turtlebot-euclid/Turtlebot_Euclid/README.md

# Turtlebot_Euclid

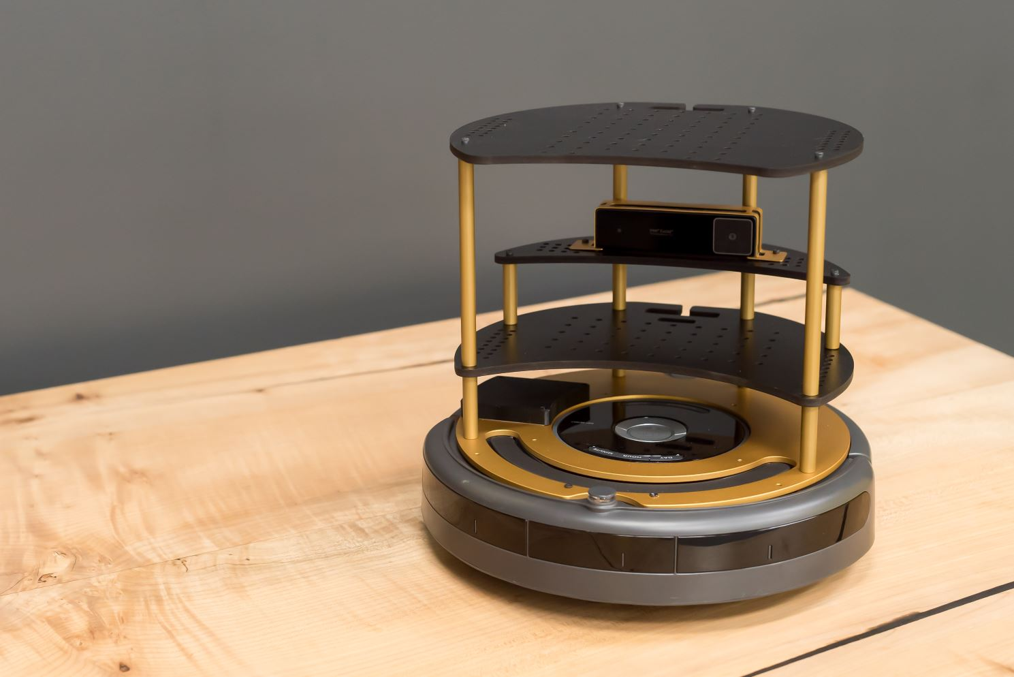
[picture p1: turtle-bot-euclid-6.jpg]
Turtlebot Euclid Promo Image


Full public repo of all design files associated with the Turtlebot Euclid
