turtlebot-euclid/Turtlebot_Euclid/Firmware/README.md

turtlebot_euclid_firmware
=========================

We use PlatformIO to program the onboard ESP8266
See tutorial here:
https://github.com/esp8266/Arduino#using-platformio
