turtlebot-euclid/Turtlebot_Euclid/Electrical/015133_C  PCB/TTBE - Main Board.step

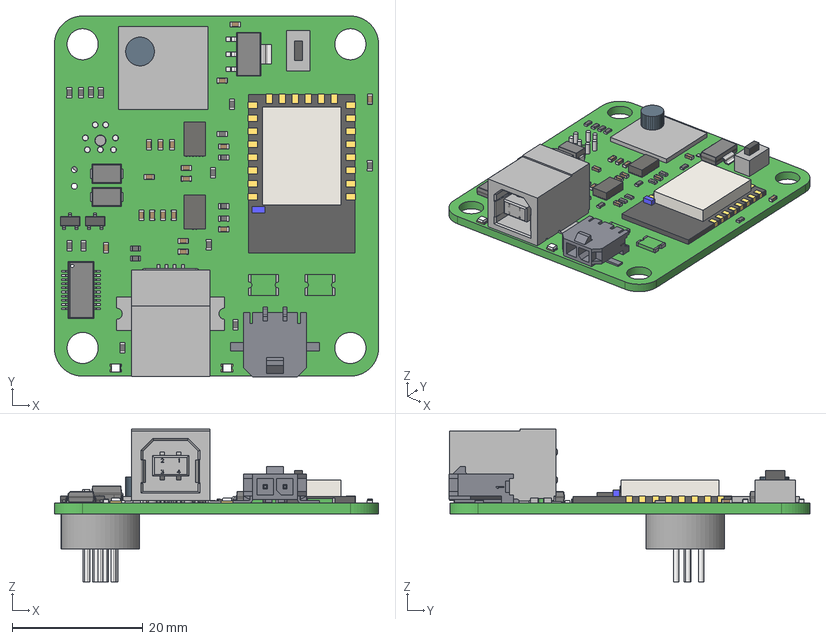
[picture p2: CAD file, 2018-04-18]
Electrical/015133_C PCB/TTBE - Main Board.step
49.6 x 55.2 x 23.4 mm
Board
User_Library-res0603-1 x 18
BL-LS0805UWC x 2
c-1734346-1-c-3d_RGB8421504
Extruded x 75
User_Library-cap_0603_lowprofile x 18
mf-msmf050_RGB32768 x 2
SW3DPS-SOT-23-DEFAULT x 2
Open_CASCADE_STEP_translator_6.8_9.1
Open_CASCADE_STEP_translator_6.8_9.2.1
Leader x 20
Open_CASCADE_STEP_translator_6.8_4.1.1
Lead x 7
Tab
Open_CASCADE_STEP_translator_6.8_7.1.1 x 2
