turtlebot-euclid/Turtlebot_Euclid/Mechanical/014845_GEO_B FOR REFRENCE ONLY.STEP

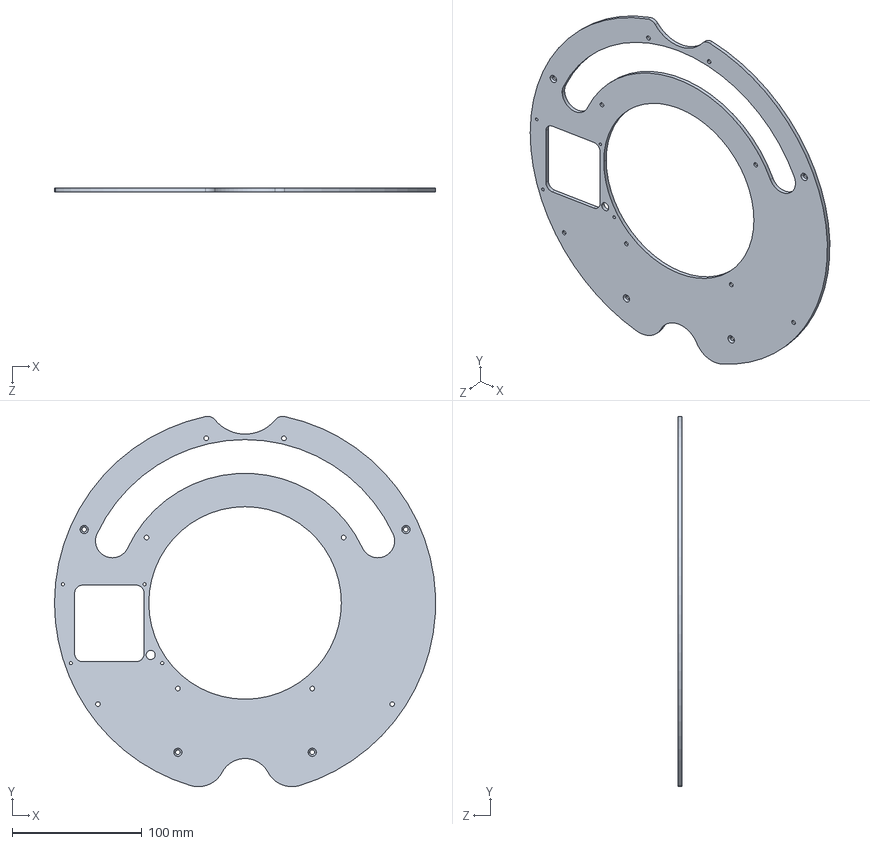
[picture p3: CAD file, 2018-04-18]
Mechanical/014845_GEO_B FOR REFRENCE ONLY.STEP
293.9 x 285.6 x 3.18 mm
