turtlebot-euclid/Turtlebot_Euclid/Mechanical/014950_GEO_B.STEP

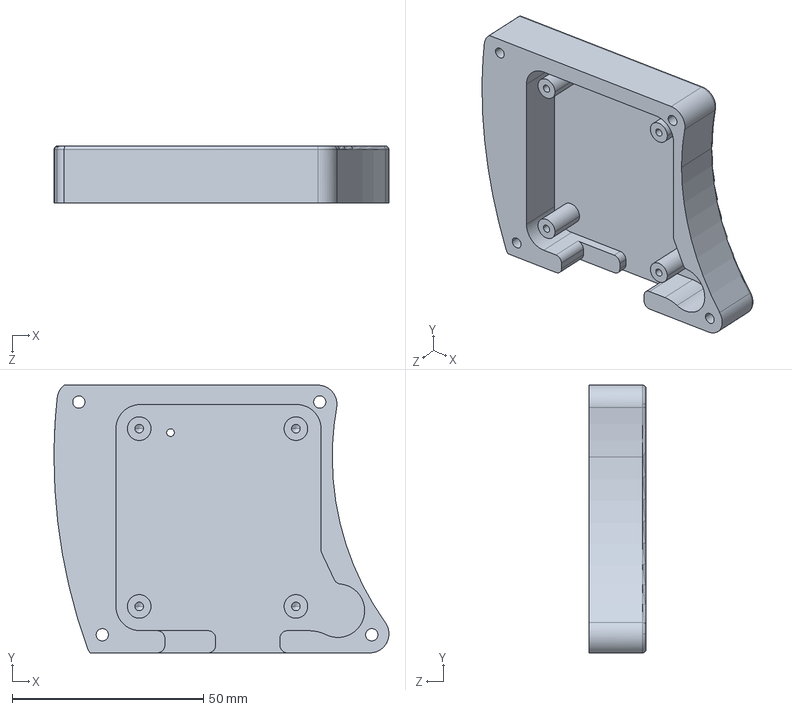
[picture p4: CAD file, 2018-04-18]
Mechanical/014950_GEO_B.STEP
87.6 x 70.0 x 15.0 mm
