turtlebot-euclid/Turtlebot_Euclid/Mechanical/014846_GEO_B FOR REFRENCE ONLY.STEP

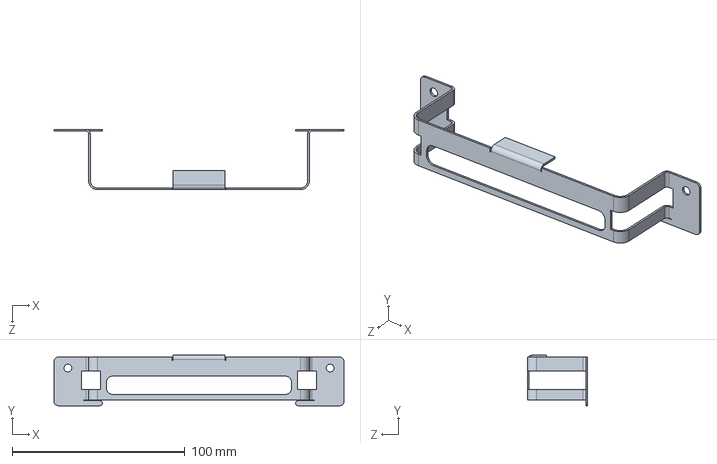
[picture p5: CAD file, 2018-04-18]
Mechanical/014846_GEO_B FOR REFRENCE ONLY.STEP
168.0 x 29.3 x 35.0 mm
