turtlebot-euclid/Turtlebot_Euclid/Mechanical/014949_GEO_B FOR REFRENCE ONLY.STEP

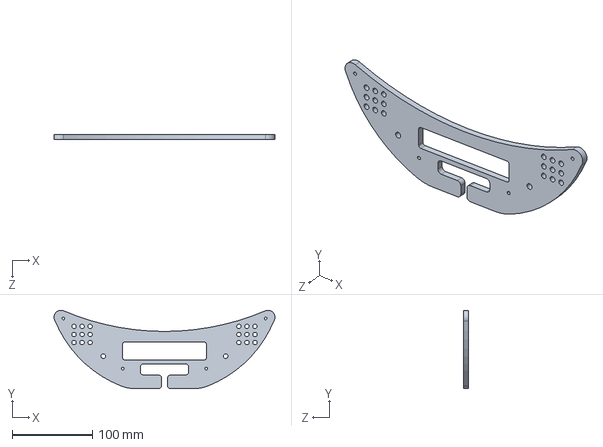
[picture p6: CAD file, 2018-04-18]
Mechanical/014949_GEO_B FOR REFRENCE ONLY.STEP
274.6 x 97.5 x 6.35 mm
