turtlebot-euclid/Turtlebot_Euclid/Mechanical/014947__GEO_B FOR REFRENCE ONLY.STEP

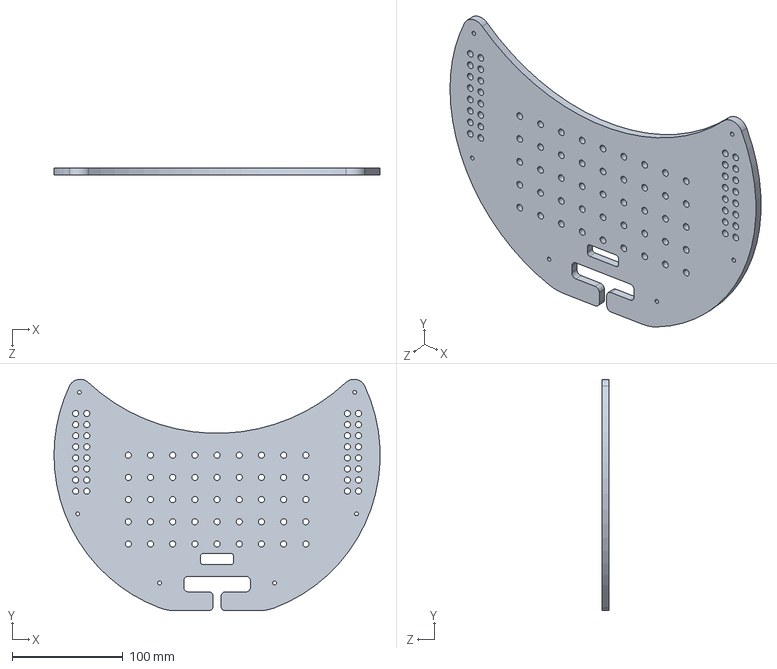
[picture p7: CAD file, 2018-04-18]
Mechanical/014947__GEO_B FOR REFRENCE ONLY.STEP
293.8 x 208.6 x 6.35 mm
