turtlebot-euclid/Turtlebot_Euclid/Mechanical/014845_GEO_B FOR REFERENCE ONLY.DXF

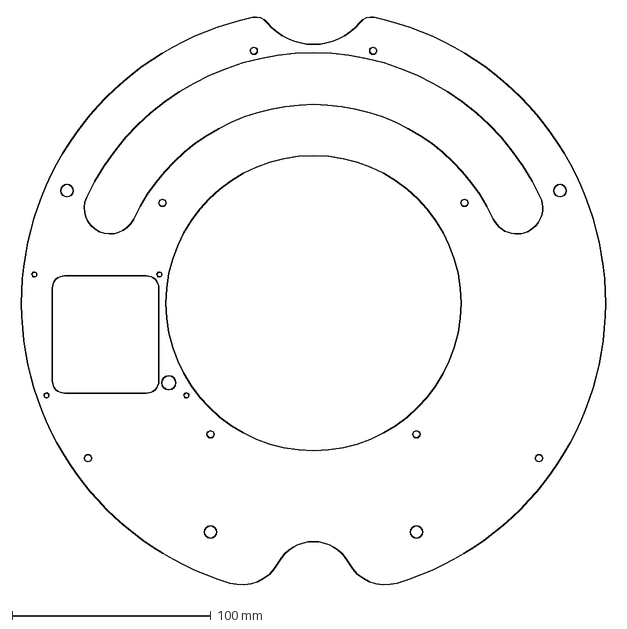
[picture p8: CAD file, 2018-04-18]
Mechanical/014845_GEO_B FOR REFERENCE ONLY.DXF
299.2 x 288.1 mm
