turtlebot-euclid/Turtlebot_Euclid/Mechanical/014848_GEO_B FOR REFRENCE ONLY.STEP

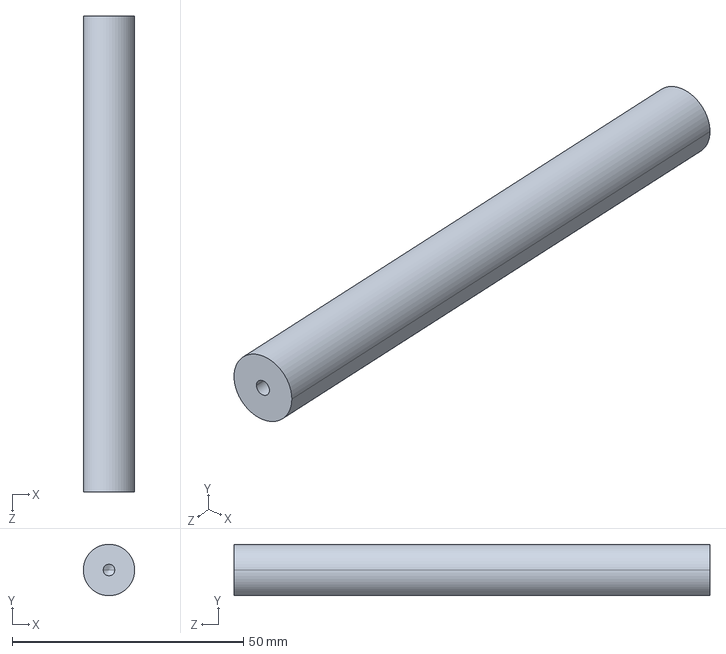
[picture p9: CAD file, 2018-04-18]
Mechanical/014848_GEO_B FOR REFRENCE ONLY.STEP
11.1 x 11.1 x 102.8 mm
