turtlebot-euclid/Turtlebot_Euclid/Mechanical/014847_GEO_B FOR REFRENCE ONLY.STEP

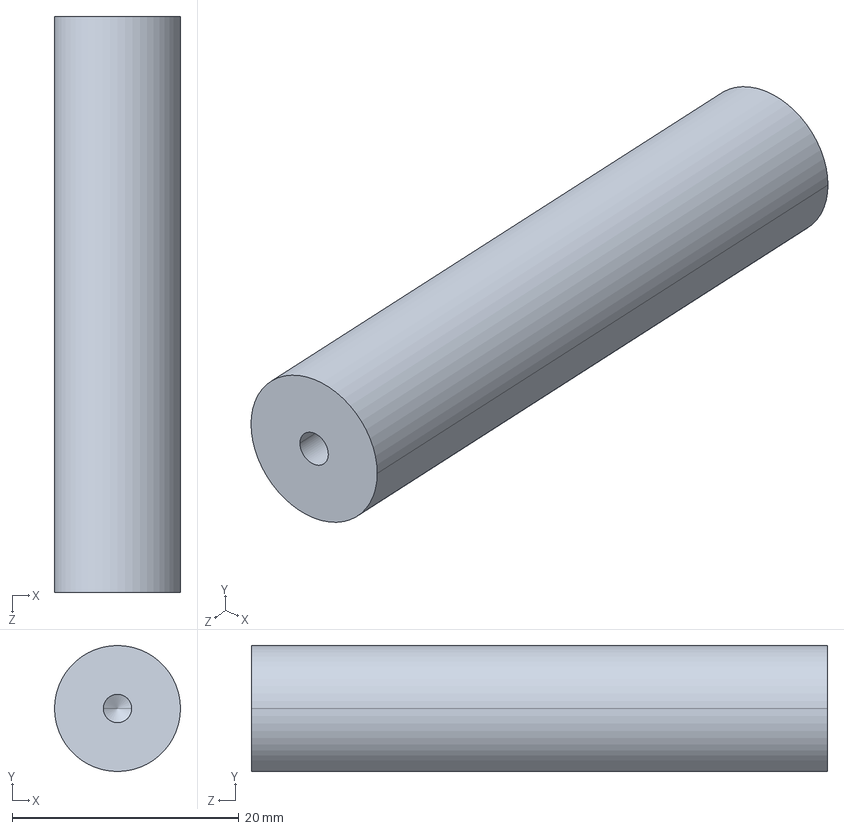
[picture p10: CAD file, 2018-04-18]
Mechanical/014847_GEO_B FOR REFRENCE ONLY.STEP
11.1 x 11.1 x 50.8 mm
