turtlebot-euclid/Turtlebot_Euclid/Mechanical/014846_FLP_B FOR REFRENCE ONLY.DXF

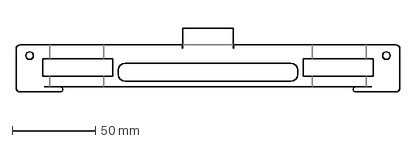
[picture p11: CAD file, 2018-04-18]
Mechanical/014846_FLP_B FOR REFRENCE ONLY.DXF
230.2 x 38.4 mm
