turtlebot-euclid/Turtlebot_Euclid/Mechanical/014849_GEO_B FOR REFRENCE ONLY.STEP

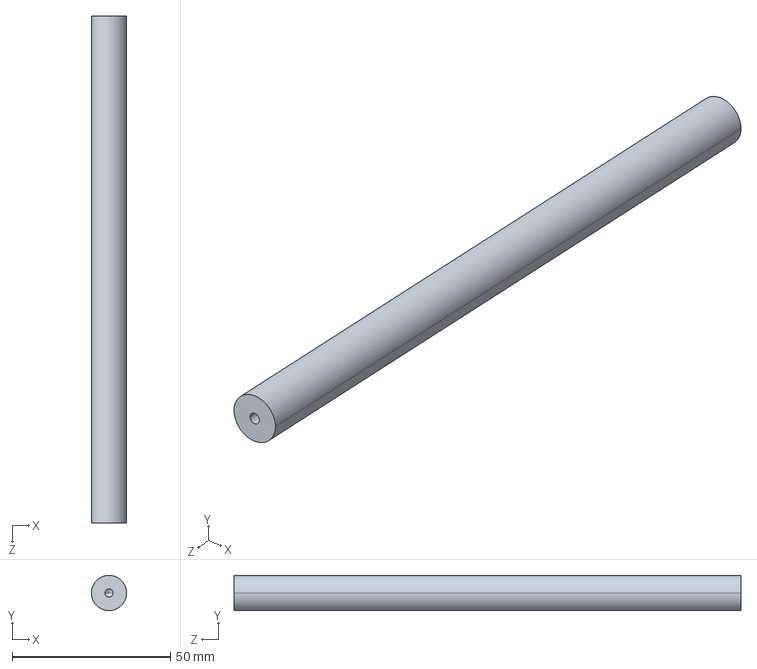
[picture p12: CAD file, 2018-04-18]
Mechanical/014849_GEO_B FOR REFRENCE ONLY.STEP
11.1 x 11.1 x 160.0 mm
