turtlebot-euclid/Turtlebot_Euclid/Mechanical/014948__GEO_B FOR REFRENCE ONLY.STEP

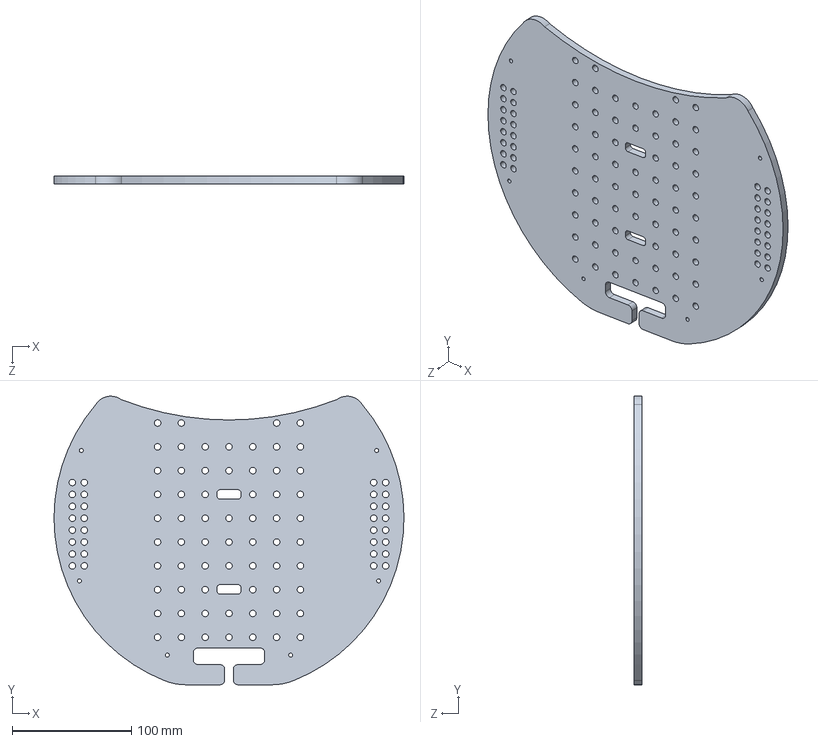
[picture p13: CAD file, 2018-04-18]
Mechanical/014948__GEO_B FOR REFRENCE ONLY.STEP
294.0 x 242.5 x 6.35 mm
