turtlebot-euclid/Turtlebot_Euclid/(list of files, cad)

Other CAD files:
Mechanical/014950_B.DXF
Mechanical/014947_GEO_B FOR REFRENCE ONLY.DXF
Mechanical/014948_GEO_B FOR REFRENCE ONLY.DXF
Mechanical/014949_GEO_B FOR REFRENCE ONLY.DXF
