turtlebot-euclid/Turtlebot_Euclid/Mechanical/014845_B.PDF

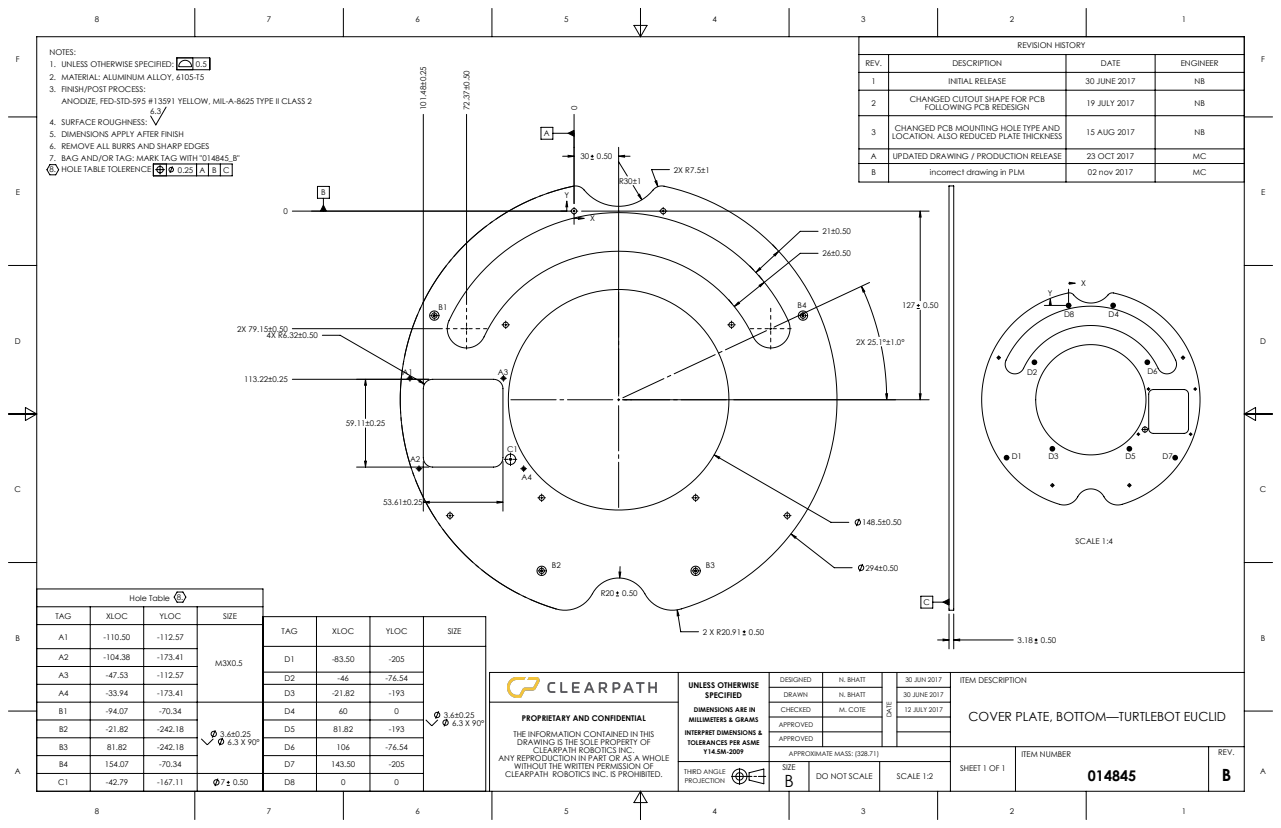
[picture p14: page 1]

NOTES:
2. MATERIAL: ALUMINUM ALLOY, 6105-T5
3. FINISH/POST PROCESS:
ANODIZE, FED-STD-595 #13591 YELLOW, MIL-A-8625 TYPE II CLASS 2
SURFACE ROUGHNESS:
5. DIMENSIONS APPLY AFTER FINISH
6. REMOVE ALL BURRS AND SHARP EDGES
7. BAG AND/OR TAG: MARK TAG WITH "014845_B"
8. HOLE TABLE TOLERENCE

REV. | DESCRIPTION | DATE | ENGINEER
1 | INITIAL RELEASE | 30 JUNE 2017 | NB
2 | CHANGED CUTOUT SHAPE FOR PCB FOLLOWING PCB REDESIGN | 19 JULY 2017 | NB

3 | CHANGED PCB MOUNTING HOLE TYPE AND LOCATION. ALSO REDUCED PLATE THICKNESS | 15 AUG 2017 | NB

A | UPDATED DRAWING / PRODUCTION RELEASE | 23 OCT 2017 | MC
B | incorrect drawing in PLM | 02 nov 2017 | MC

TAG | XLOC | YLOC | SIZE

-104.38 | -173.41 | M3X0.5 A2 | D1 | -83.50 | -205 | 3.6±0.25 6.3 X 90°
A3 | -47.53 | -112.57
A4 | -33.94 | -173.41 | | D3 | -21.82 | -193
B1 | -94.07 | -70.34 | 3.6±0.25 6.3 X 90° | D4 | 60 | 0
B2 | -21.82 | -242.18 | | D5 | 81.82 | -193
B3 | 81.82 | -242.18 | | D6 | 106 | -76.54
B4 | 154.07 | -70.34 | | D7 | 143.50 | -205
C1 | -42.79 | -167.11 | 7 0.50 | D8 | 0 | 0

COVER PLATE, BOTTOM—TURTLEBOT EUCLID

PROPRIETARY AND CONFIDENTIAL
THE INFORMATION CONTAINED IN THIS
DRAWING IS THE SOLE PROPERTY OF
CLEARPATH ROBOTICS INC.
WITHOUT THE WRITTEN PERMISSION OF
CLEARPATH ROBOTICS INC. IS PROHIBITED.

ANY REPRODUCTION IN PART OR AS A WHOLE
