turtlebot-euclid/Turtlebot_Euclid/Mechanical/014846._B.PDF

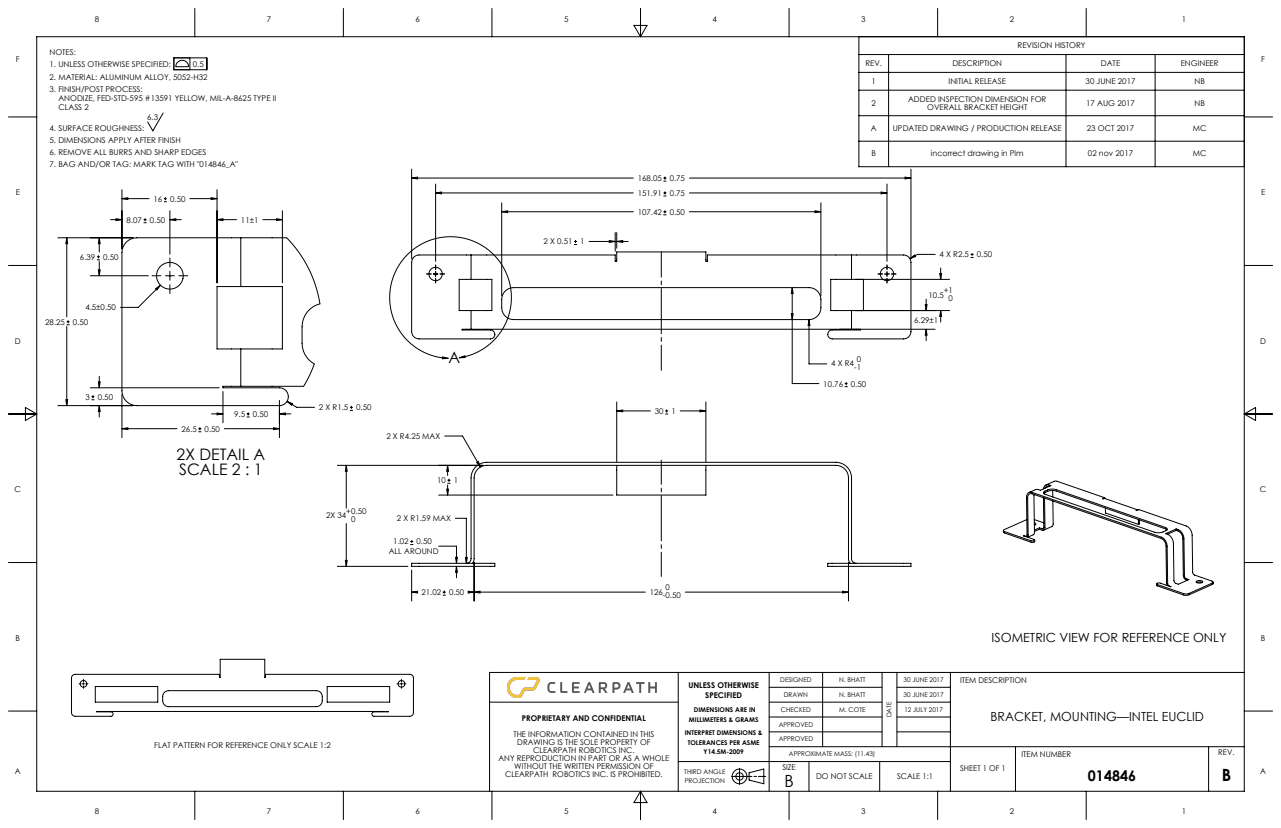
[picture p15: page 1]
1.02 0.50 ALL AROUND; 2 X R1.59 MAX; 2 X R4.25 MAX; 2X DETAIL A SCALE 2 : 1; 1. UNLESS OTHERWISE SPECIFIED:; REVISION HISTORY; THIRD ANGLE; DO NOT SCALE; N. BHATT; M. COTE; 30 JUNE 2017; 12 JULY 2017; APPROXIMATE MASS: (11.43); ITEM NUMBER; SHEET 1 OF 1; SCALE 1:1; ITEM DESCRIPTION

NOTES:
2. MATERIAL: ALUMINUM ALLOY, 5052-H32
3. FINISH/POST PROCESS:
ANODIZE, FED-STD-595 #13591 YELLOW, MIL-A-8625 TYPE II
CLASS 2
SURFACE ROUGHNESS:
5. DIMENSIONS APPLY AFTER FINISH
6. REMOVE ALL BURRS AND SHARP EDGES
7. BAG AND/OR TAG: MARK TAG WITH "014846_A"

REV. | DESCRIPTION | DATE | ENGINEER
1 | INITIAL RELEASE | 30 JUNE 2017 | NB
2 | ADDED INSPECTION DIMENSION FOR OVERALL BRACKET HEIGHT | 17 AUG 2017 | NB

A | UPDATED DRAWING / PRODUCTION RELEASE | 23 OCT 2017 | MC

B | incorrect drawing in Plm | 02 nov 2017 | MC

ISOMETRIC VIEW FOR REFERENCE ONLY

UNLESS OTHERWISE
SPECIFIED
DIMENSIONS ARE IN
MILLIMETERS & GRAMS
INTERPRET DIMENSIONS &
TOLERANCES PER ASME

BRACKET, MOUNTING—INTEL EUCLID

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

FLAT PATTERN FOR REFERENCE ONLY SCALE 1:2

ANY REPRODUCTION IN PART OR AS A WHOLE
