turtlebot-euclid/Turtlebot_Euclid/Mechanical/014847_B.PDF

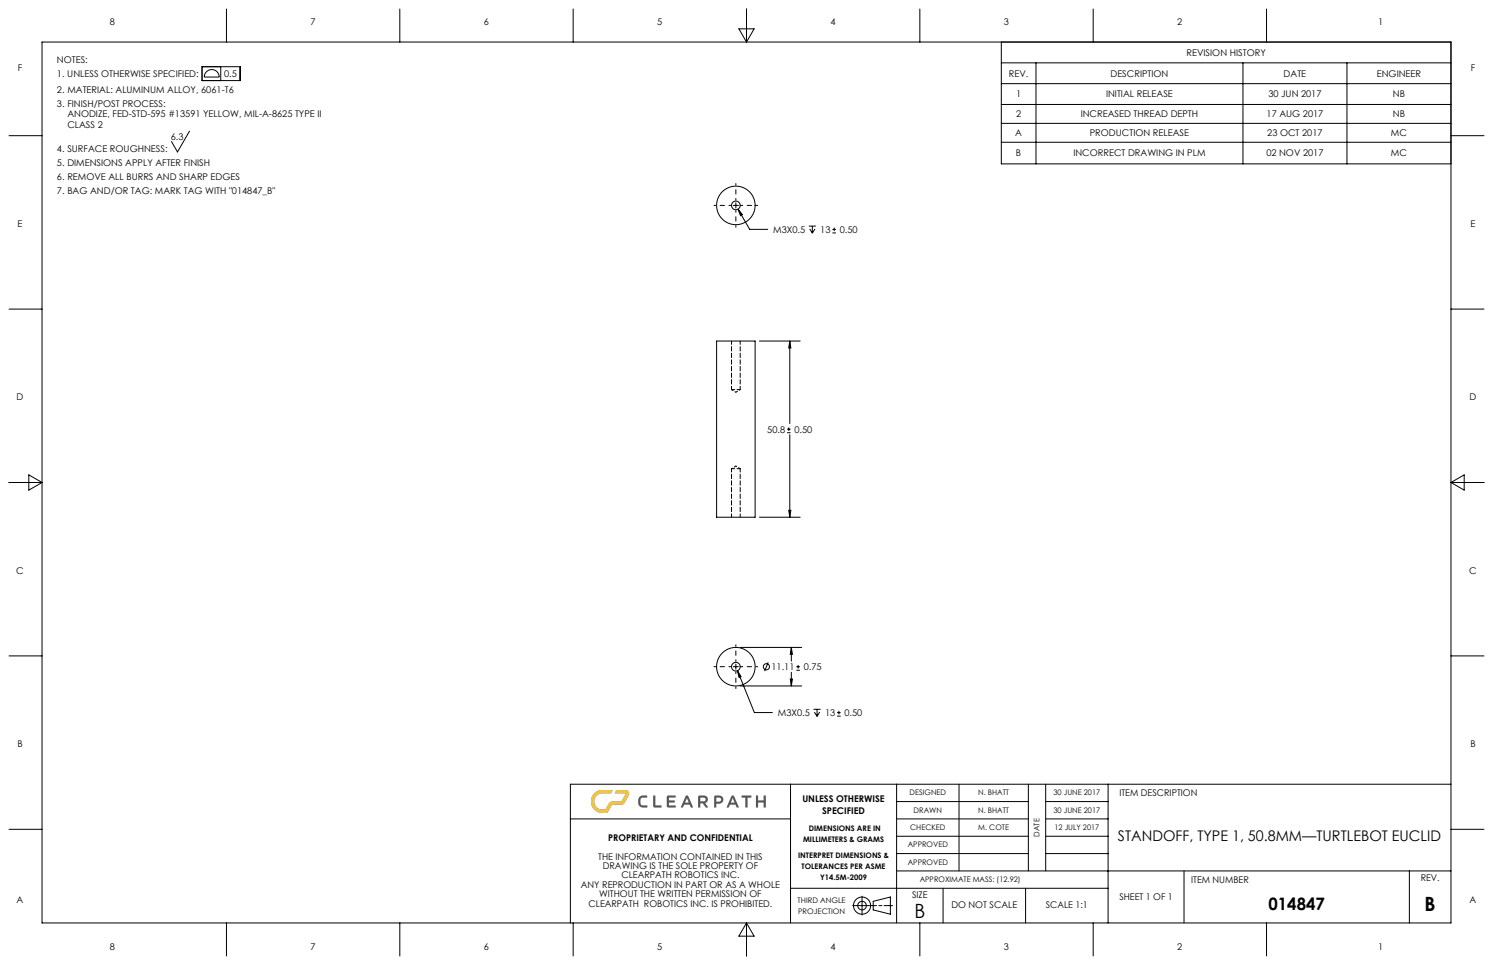
[picture p16: page 1]
1. UNLESS OTHERWISE SPECIFIED:; REVISION HISTORY; THIRD ANGLE; DO NOT SCALE; N. BHATT; M. COTE; 30 JUNE 2017; 12 JULY 2017; APPROXIMATE MASS: (12.92); ITEM NUMBER; SHEET 1 OF 1; SCALE 1:1; ITEM DESCRIPTION

NOTES:
2. MATERIAL: ALUMINUM ALLOY, 6061-T6
3. FINISH/POST PROCESS:
ANODIZE, FED-STD-595 #13591 YELLOW, MIL-A-8625 TYPE II
CLASS 2
SURFACE ROUGHNESS:
5. DIMENSIONS APPLY AFTER FINISH
6. REMOVE ALL BURRS AND SHARP EDGES
7. BAG AND/OR TAG: MARK TAG WITH "014847_B"

REV. | DESCRIPTION | DATE | ENGINEER
1 | INITIAL RELEASE | 30 JUN 2017 | NB
2 | INCREASED THREAD DEPTH | 17 AUG 2017 | NB
A | PRODUCTION RELEASE | 23 OCT 2017 | MC
B | INCORRECT DRAWING IN PLM | 02 NOV 2017 | MC

UNLESS OTHERWISE
SPECIFIED
DIMENSIONS ARE IN
MILLIMETERS & GRAMS
INTERPRET DIMENSIONS &
TOLERANCES PER ASME

STANDOFF, TYPE 1, 50.8MM—TURTLEBOT EUCLID

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

ANY REPRODUCTION IN PART OR AS A WHOLE
