turtlebot-euclid/Turtlebot_Euclid/Mechanical/014949_B.PDF

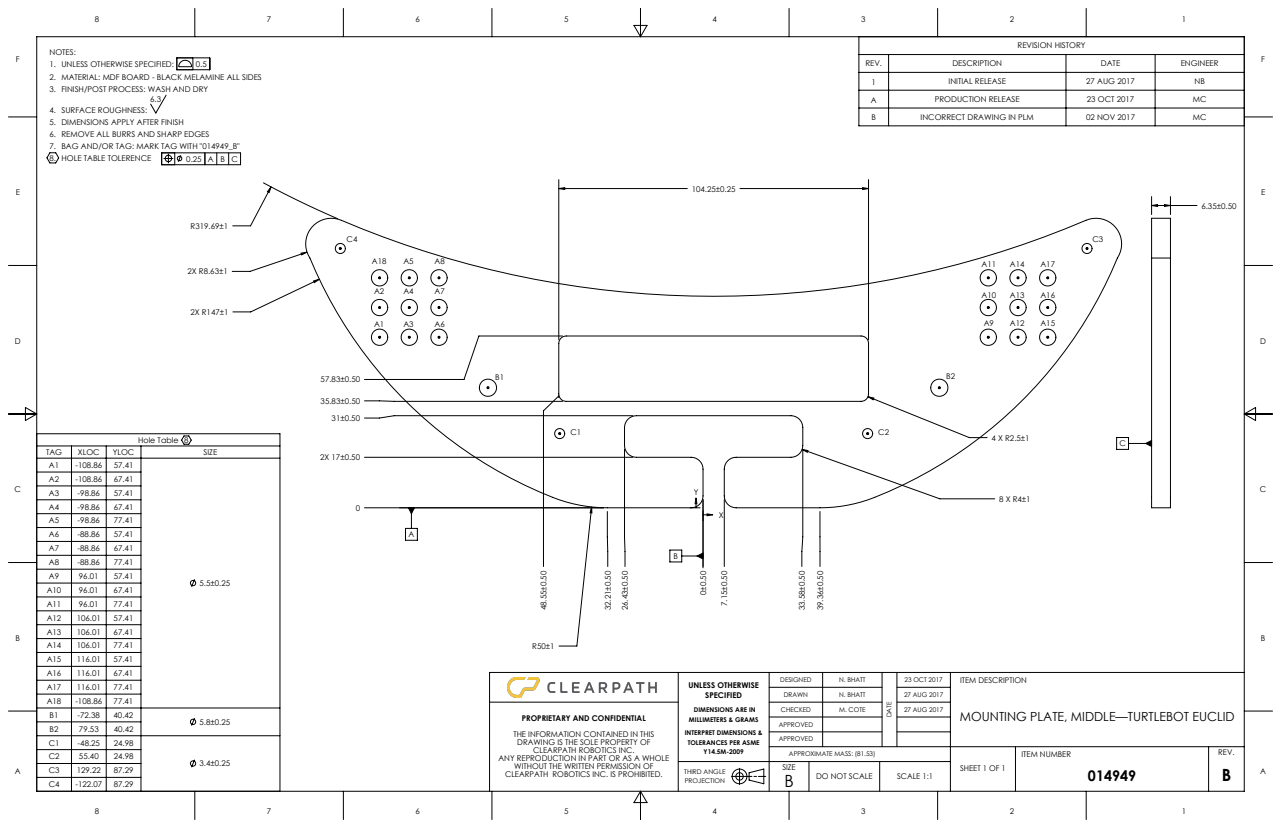
[picture p17: page 1]
1. UNLESS OTHERWISE SPECIFIED:; REVISION HISTORY; Hole Table; THIRD ANGLE; DO NOT SCALE; N. BHATT; M. COTE; 23 OCT 2017; 27 AUG 2017; APPROXIMATE MASS: (81.53); ITEM NUMBER; SHEET 1 OF 1; SCALE 1:1; ITEM DESCRIPTION; CLEARPATH ROBOTICS INC. IS PROHIBITED. A

NOTES:
2. MATERIAL: MDF BOARD - BLACK MELAMINE ALL SIDES
3. FINISH/POST PROCESS: WASH AND DRY
SURFACE ROUGHNESS:
5. DIMENSIONS APPLY AFTER FINISH
6. REMOVE ALL BURRS AND SHARP EDGES
7. BAG AND/OR TAG: MARK TAG WITH "014949_B"
8. HOLE TABLE TOLERENCE

REV. | DESCRIPTION | DATE | ENGINEER
1 | INITIAL RELEASE | 27 AUG 2017 | NB
A | PRODUCTION RELEASE | 23 OCT 2017 | MC
B | INCORRECT DRAWING IN PLM | 02 NOV 2017 | MC

TAG | XLOC | YLOC | SIZE
A1 | -108.86 | 57.41
A2 | -108.86 | 67.41
A3 | -98.86 | 57.41
A4 | -98.86 | 67.41
A5 | -98.86 | 77.41

A7 | -88.86 | 67.41
A8 | -88.86 | 77.41
A9 | 96.01 | 57.41
A10 | 96.01 | 67.41
A11 | 96.01 | 77.41
A12 | 106.01 | 57.41
A13 | 106.01 | 67.41
A14 | 106.01 | 77.41
A15 | 116.01 | 57.41
A16 | 116.01 | 67.41
A17 | 116.01 | 77.41
A18 | -108.86 | 77.41
B1 | -72.38 | 40.42 | 5.8±0.25
B2 | 79.53 | 40.42
C1 | -48.25 | 24.98 | 3.4±0.25
C2 | 55.40 | 24.98
C3 | 129.22 | 87.29
C4 | -122.07 | 87.29

UNLESS OTHERWISE
SPECIFIED
DIMENSIONS ARE IN
MILLIMETERS & GRAMS
INTERPRET DIMENSIONS &
TOLERANCES PER ASME

MOUNTING PLATE, MIDDLE—TURTLEBOT EUCLID

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

ANY REPRODUCTION IN PART OR AS A WHOLE
