turtlebot-euclid/Turtlebot_Euclid/Mechanical/014950_B.PDF

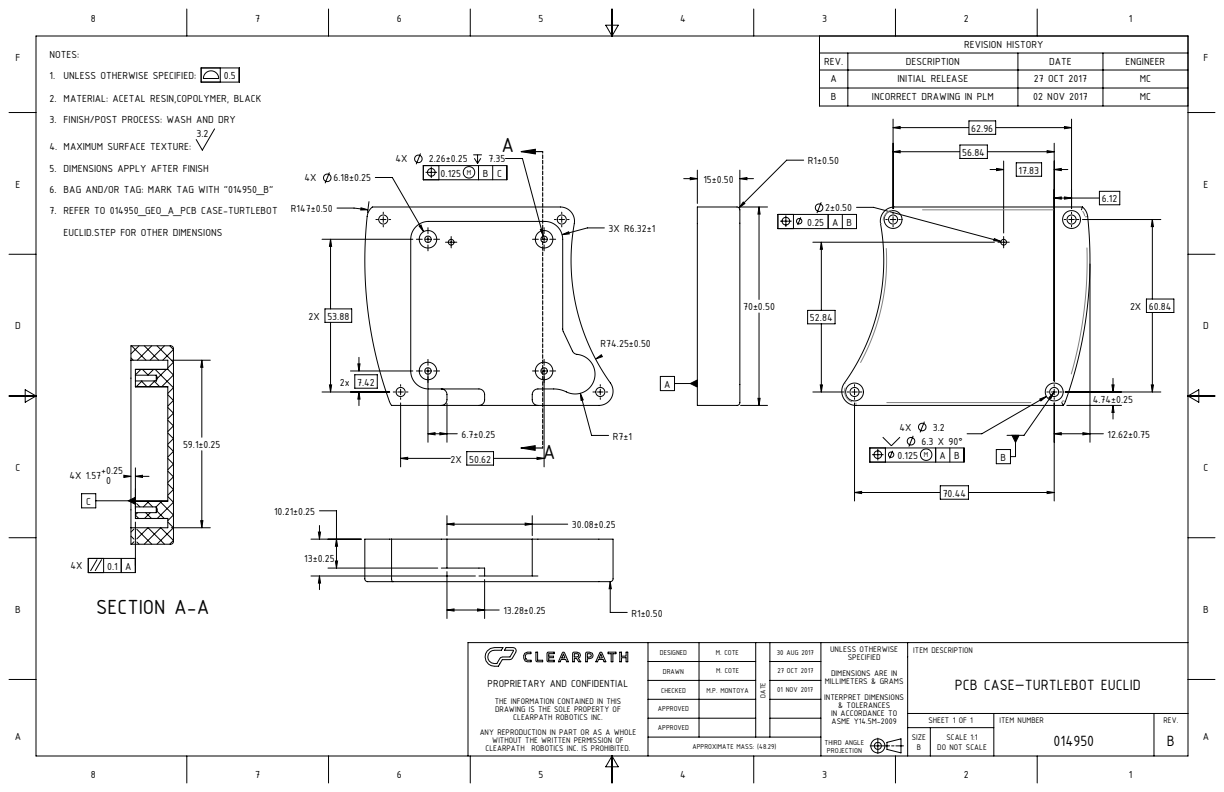
[picture p18: page 1]
SECTION A-A; 1. UNLESS OTHERWISE SPECIFIED:; REVISION HISTORY; M. COTE; M.P. MONTOYA; 27 OCT 2017; 01 NOV 2017; APPROXIMATE MASS: (48.29); SHEET 1 OF 1; ITEM NUMBER; SCALE 1:1 DO NOT SCALE; 30 AUG 2017; THIRD ANGLE

NOTES:
2. MATERIAL: ACETAL RESIN,COPOLYMER, BLACK
3. FINISH/POST PROCESS: WASH AND DRY

REV. | DESCRIPTION | DATE | ENGINEER
A | INITIAL RELEASE | 27 OCT 2017 | MC
B | INCORRECT DRAWING IN PLM | 02 NOV 2017 | MC

MAXIMUM SURFACE TEXTURE:
5. DIMENSIONS APPLY AFTER FINISH
6. BAG AND/OR TAG: MARK TAG WITH "014950_B"
7. REFER TO 014950_GEO_A_PCB CASE-TURTLEBOT
EUCLID.STEP FOR OTHER DIMENSIONS

UNLESS OTHERWISE
SPECIFIED
DIMENSIONS ARE IN
MILLIMETERS & GRAMS
INTERPRET DIMENSIONS
& TOLERANCES
IN ACCORDANCE TO
ASME Y14.5M-2009

ITEM DESCRIPTION
PCB CASE—TURTLEBOT EUCLID

PROPRIETARY AND CONFIDENTIAL
THE INFORMATION CONTAINED IN THIS
DRAWING IS THE SOLE PROPERTY OF
CLEARPATH ROBOTICS INC. ANY REPRODUCTION IN PART OR AS A WHOLE

WITHOUT THE WRITTEN PERMISSION OF
CLEARPATH ROBOTICS INC. IS PROHIBITED.
