turtlebot-euclid/Turtlebot_Euclid/Electrical/015133_C  PCB/TTBE-Main Board.pdf

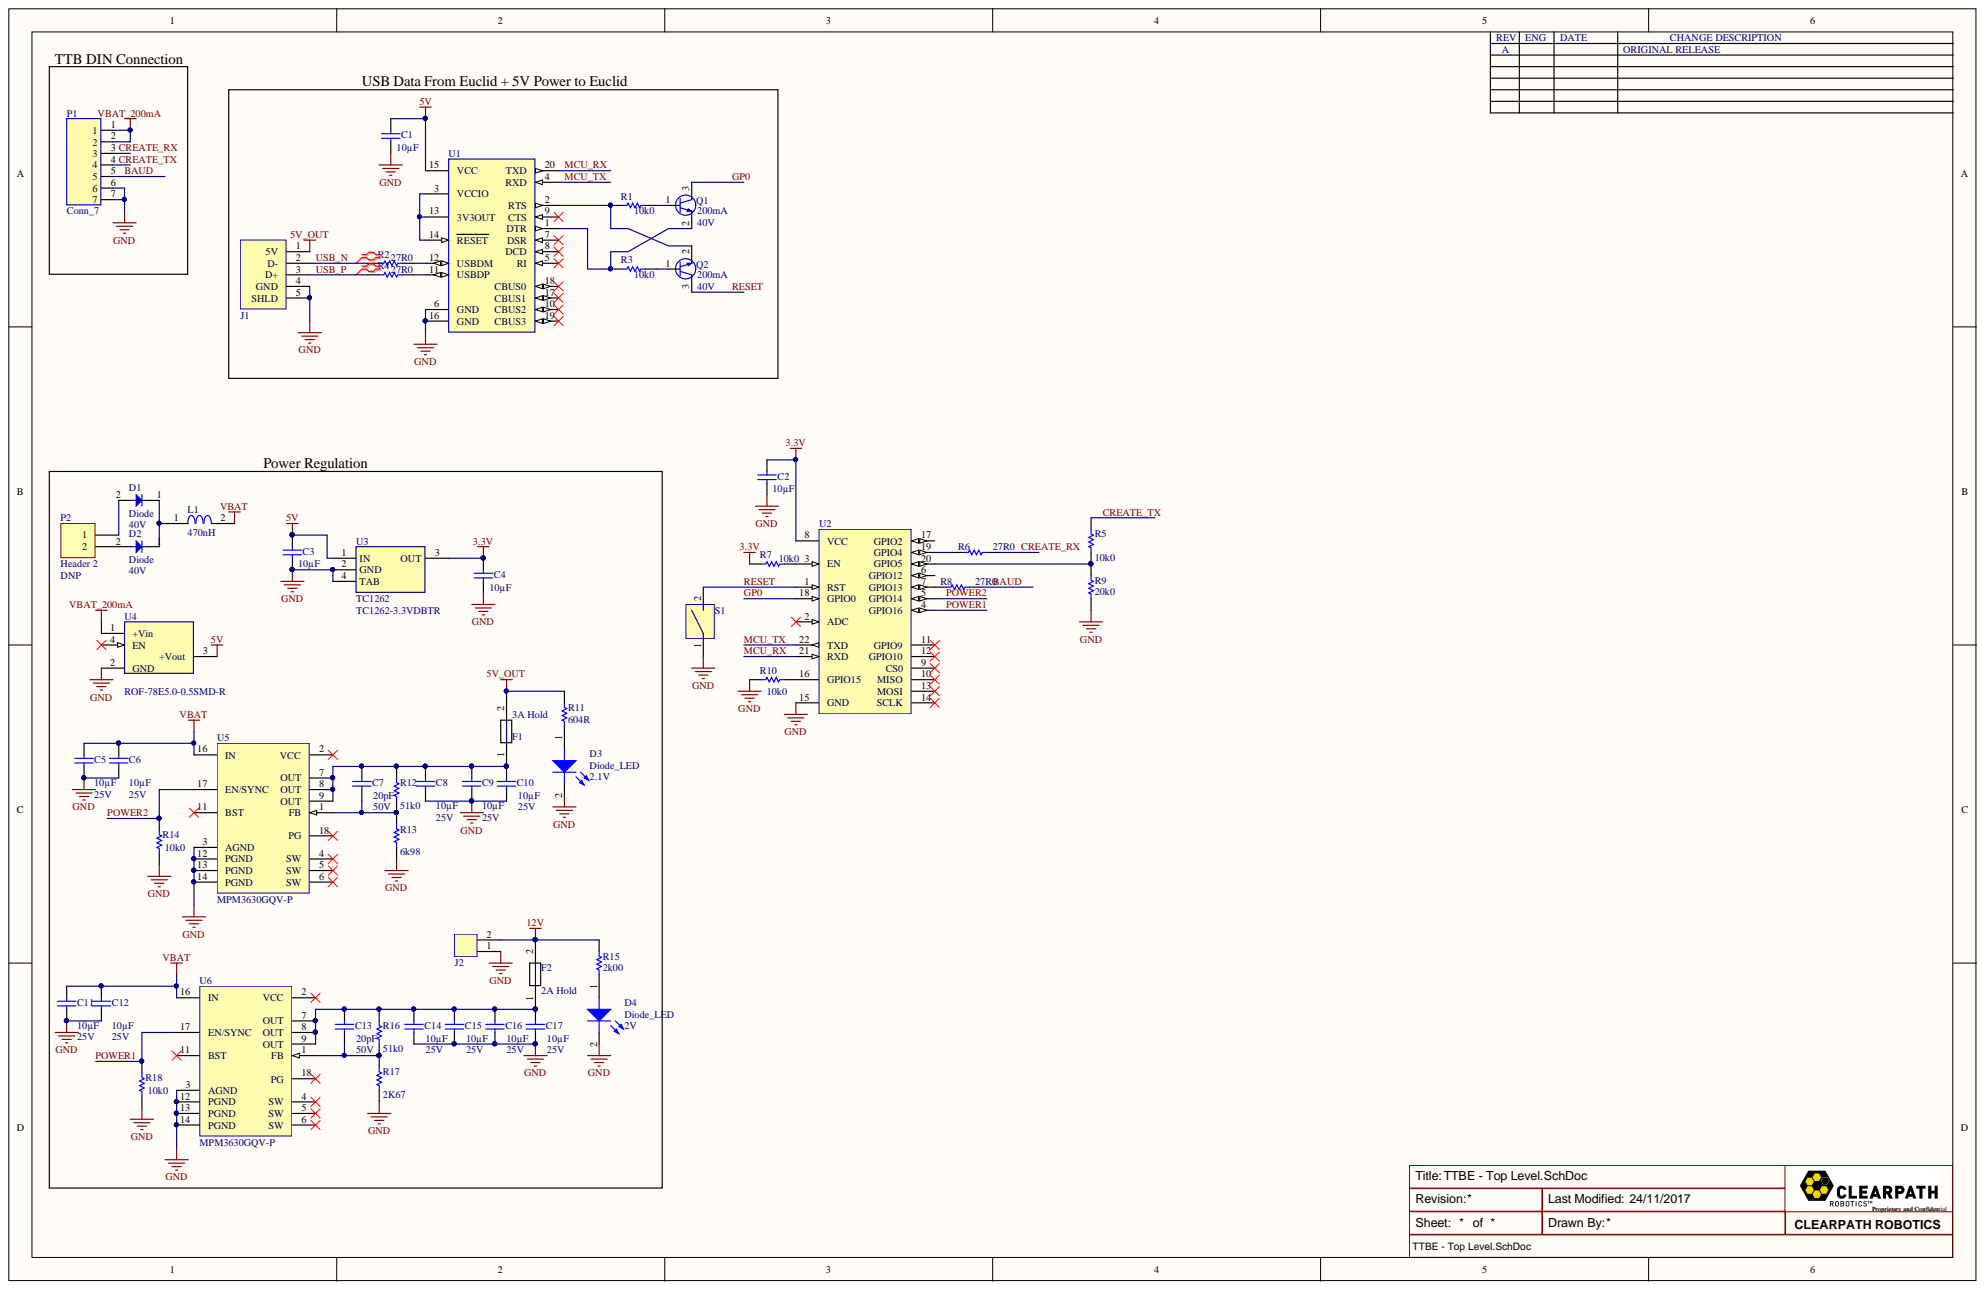
[picture p19: page 1]

REV | ENG | DATE | CHANGE DESCRIPTION
A | | | ORIGINAL RELEASE

USB Data From Euclid + 5V Power to Euclid

Title:TTBE - Top Level.SchDoc

Revision:* | Last Modified: 24/11/2017

Sheet: * of * | Drawn By:* | CLEARPATH ROBOTICS

TTBE - Top Level.SchDoc

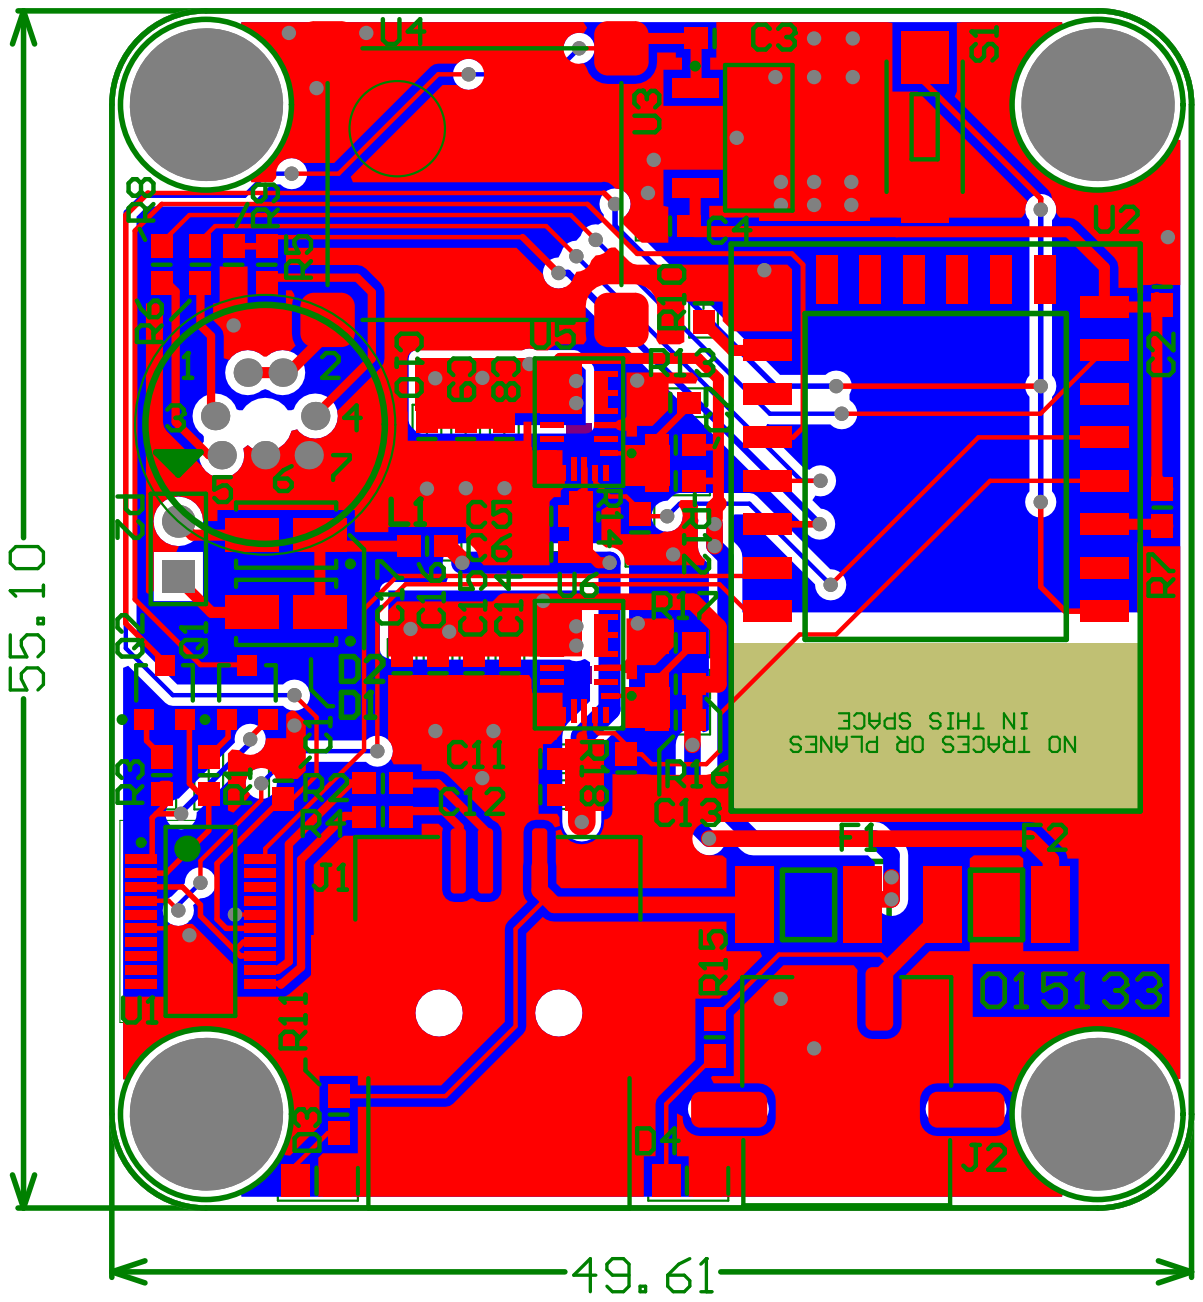
[picture p20: page 2]
