turtlebot-euclid/Turtlebot_Euclid/Mechanical/014837_B.PDF

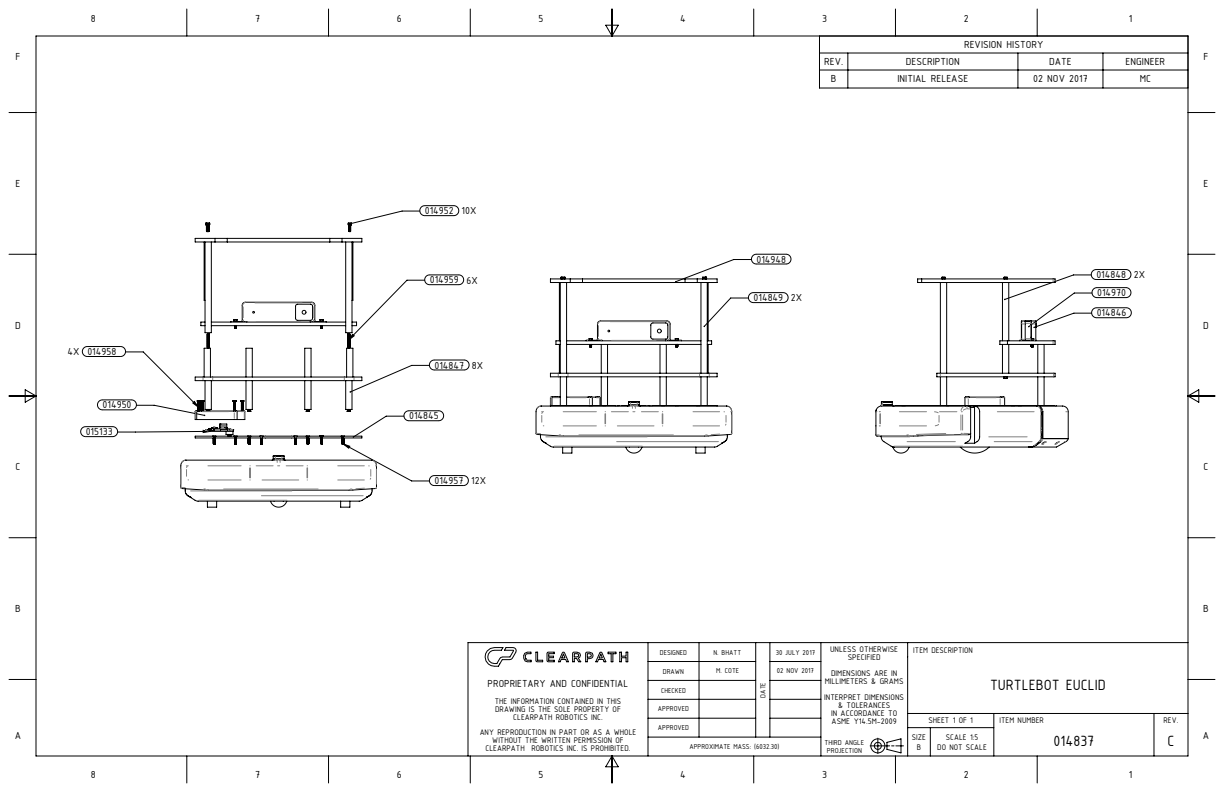
[picture p21: page 1]
REVISION HISTORY; M. COTE; 02 NOV 2017; APPROXIMATE MASS: (6032.30); SHEET 1 OF 1; ITEM NUMBER; SCALE 1:5 DO NOT SCALE; TURTLEBOT EUCLID; ITEM DESCRIPTION; N. BHATT; 30 JULY 2017; THIRD ANGLE

REV. | DESCRIPTION | DATE | ENGINEER
B | INITIAL RELEASE | 02 NOV 2017 | MC

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

WITHOUT THE WRITTEN PERMISSION OF
CLEARPATH ROBOTICS INC. IS PROHIBITED.
