turtlebot-euclid/Turtlebot_Euclid/Mechanical/014947_B.PDF

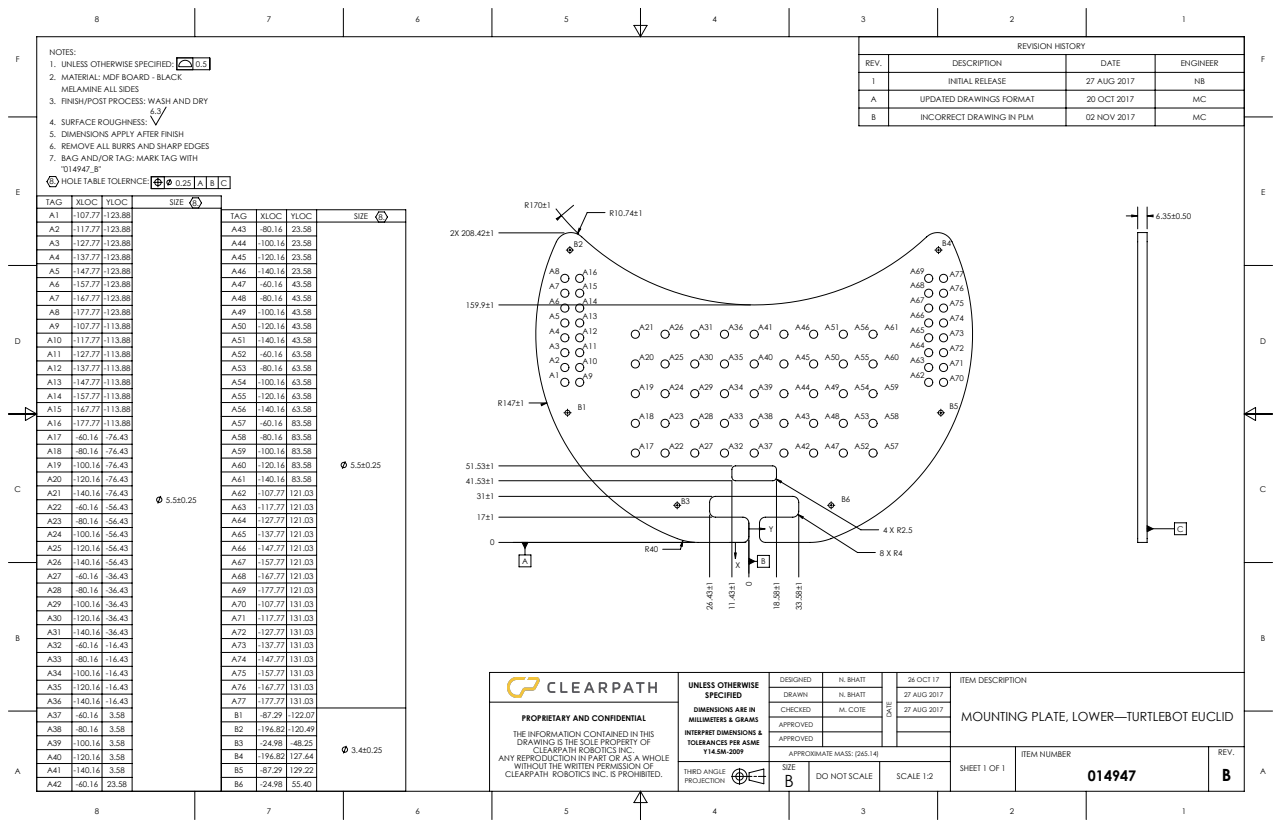
[picture p22: page 1]
1. UNLESS OTHERWISE SPECIFIED:; REVISION HISTORY; THIRD ANGLE; DO NOT SCALE; N. BHATT; M. COTE; 26 OCT 17; 27 AUG 2017; APPROXIMATE MASS: (265.14); ITEM NUMBER; SHEET 1 OF 1; SCALE 1:2; ITEM DESCRIPTION

NOTES:
2. MATERIAL: MDF BOARD - BLACK
MELAMINE ALL SIDES
3. FINISH/POST PROCESS: WASH AND DRY
SURFACE ROUGHNESS:
5. DIMENSIONS APPLY AFTER FINISH
6. REMOVE ALL BURRS AND SHARP EDGES
7. BAG AND/OR TAG: MARK TAG WITH
8. HOLE TABLE TOLERNCE:

REV. | DESCRIPTION | DATE | ENGINEER
1 | INITIAL RELEASE | 27 AUG 2017 | NB
A | UPDATED DRAWINGS FORMAT | 20 OCT 2017 | MC
B | INCORRECT DRAWING IN PLM | 02 NOV 2017 | MC

TAG | XLOC | YLOC | SIZE 8.
A1 | -107.77 | -123.88 | | TAG | XLOC | YLOC | SIZE 8.
A2 | -117.77 | -123.88 | | A43 | -80.16 | 23.58
A3 | -127.77 | -123.88 | | A44 | -100.16 | 23.58
A4 | -137.77 | -123.88 | | A45 | -120.16 | 23.58
A5 | -147.77 | -123.88 | | A46 | -140.16 | 23.58
A6 | -157.77 | -123.88 | | A47 | -60.16 | 43.58
A7 | -167.77 | -123.88 | | A48 | -80.16 | 43.58
A8 | -177.77 | -123.88 | | A49 | -100.16 | 43.58
A9 | -107.77 | -113.88 | | A50 | -120.16 | 43.58
A10 | -117.77 | -113.88 | | A51 | -140.16 | 43.58
A11 | -127.77 | -113.88 | | A52 | -60.16 | 63.58
A12 | -137.77 | -113.88 | | A53 | -80.16 | 63.58
A13 | -147.77 | -113.88 | | A54 | -100.16 | 63.58

A14 | -157.77 | -113.88 | | A55 | -120.16 | 63.58
A15 | -167.77 | -113.88 | | A56 | -140.16 | 63.58
A16 | -177.77 | -113.88 | | A57 | -60.16 | 83.58
A17 | -60.16 | -76.43 | | A58 | -80.16 | 83.58
A18 | -80.16 | -76.43 | | A59 | -100.16 | 83.58
A19 | -100.16 | -76.43 | | A60 | -120.16 | 83.58
A20 | -120.16 | -76.43 | | A61 | -140.16 | 83.58
A21 | -140.16 | -76.43 | | A62 | -107.77 | 121.03
A22 | -60.16 | -56.43 | | A63 | -117.77 | 121.03
A23 | -80.16 | -56.43 | | A64 | -127.77 | 121.03

A24 | -100.16 | -56.43 | | A65 | -137.77 | 121.03
A25 | -120.16 | -56.43 | | A66 | -147.77 | 121.03
A26 | -140.16 | -56.43 | | A67 | -157.77 | 121.03
A27 | -60.16 | -36.43 | | A68 | -167.77 | 121.03
A28 | -80.16 | -36.43 | | A69 | -177.77 | 121.03
A29 | -100.16 | -36.43 | | A70 | -107.77 | 131.03
A30 | -120.16 | -36.43 | | A71 | -117.77 | 131.03
A31 | -140.16 | -36.43 | | A72 | -127.77 | 131.03
A32 | -60.16 | -16.43 | | A73 | -137.77 | 131.03
A33 | -80.16 | -16.43 | | A74 | -147.77 | 131.03
A34 | -100.16 | -16.43 | | A75 | -157.77 | 131.03
A35 | -120.16 | -16.43 | | A76 | -167.77 | 131.03
A36 | -140.16 | -16.43 | | A77 | -177.77 | 131.03
A37 | -60.16 | 3.58 | | B1 | -87.29 | -122.07 | 3.4±0.25
A38 | -80.16 | 3.58 | | B2 | -196.82 | -120.49
A39 | -100.16 | 3.58 | | B3 | -24.98 | -48.25
A40 | -120.16 | 3.58 | | B4 | -196.82 | 127.64
A41 | -140.16 | 3.58 | | B5 | -87.29 | 129.22
A42 | -60.16 | 23.58 | | B6 | -24.98 | 55.40

UNLESS OTHERWISE
SPECIFIED
DIMENSIONS ARE IN
MILLIMETERS & GRAMS
INTERPRET DIMENSIONS &
TOLERANCES PER ASME

MOUNTING PLATE, LOWER—TURTLEBOT EUCLID

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

ANY REPRODUCTION IN PART OR AS A WHOLE
