turtlebot-euclid/Turtlebot_Euclid/Mechanical/014948_B.PDF

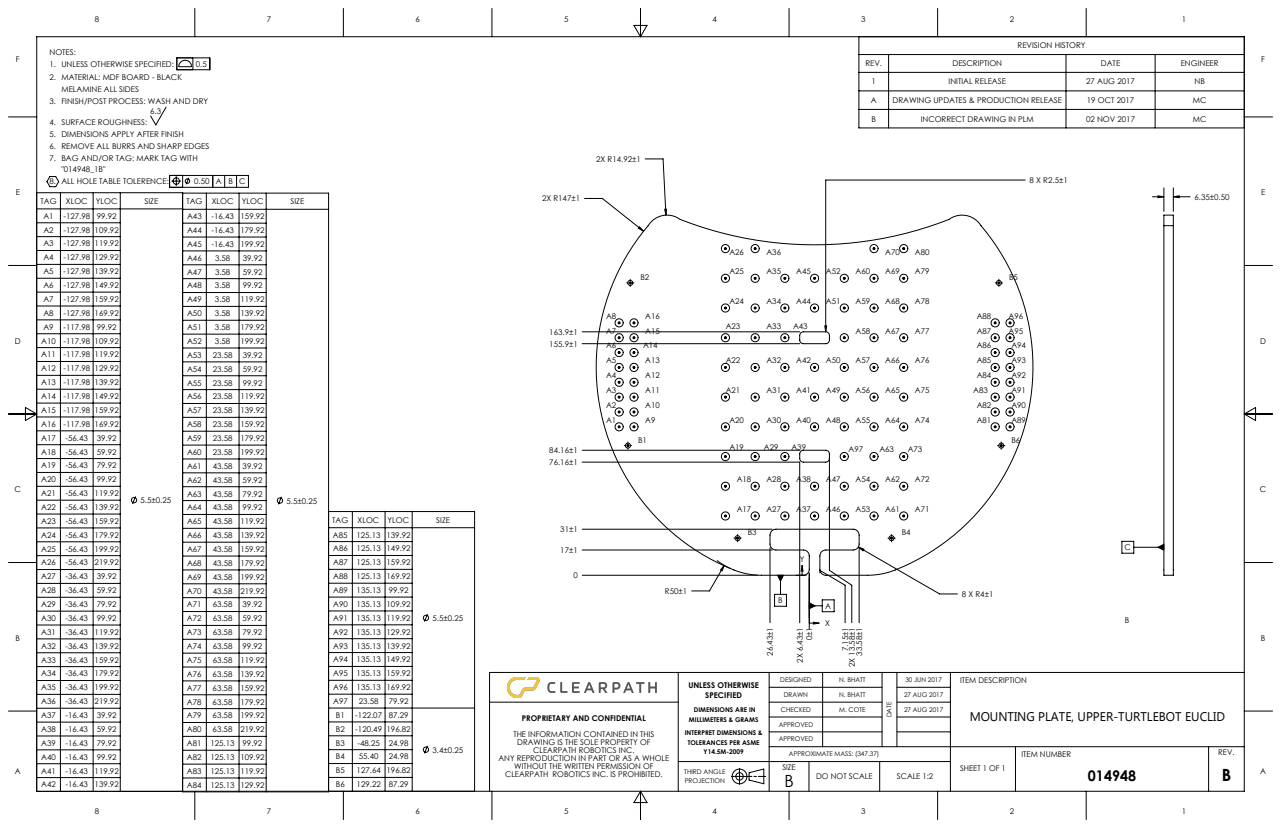
[picture p23: page 1]
1. UNLESS OTHERWISE SPECIFIED:; 8. ALL HOLE TABLE TOLERENCE:; REVISION HISTORY; THIRD ANGLE; DO NOT SCALE; N. BHATT; M. COTE; 30 JUN 2017; 27 AUG 2017; APPROXIMATE MASS: (347.37); ITEM NUMBER; SHEET 1 OF 1; SCALE 1:2; ITEM DESCRIPTION

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

REV. | DESCRIPTION | DATE | ENGINEER
1 | INITIAL RELEASE | 27 AUG 2017 | NB
A | DRAWING UPDATES & PRODUCTION RELEASE | 19 OCT 2017 | MC
B | INCORRECT DRAWING IN PLM | 02 NOV 2017 | MC

TAG | XLOC | YLOC | SIZE | TAG | XLOC | YLOC | SIZE
A1 | -127.98 | 99.92 | | A43 | -16.43 | 159.92
A2 | -127.98 | 109.92 | | A44 | -16.43 | 179.92
A3 | -127.98 | 119.92 | | A45 | -16.43 | 199.92
A4 | -127.98 | 129.92 | | A46 | 3.58 | 39.92
A5 | -127.98 | 139.92 | | A47 | 3.58 | 59.92
A6 | -127.98 | 149.92 | | A48 | 3.58 | 99.92
A7 | -127.98 | 159.92 | | A49 | 3.58 | 119.92
A8 | -127.98 | 169.92 | | A50 | 3.58 | 139.92
A9 | -117.98 | 99.92 | | A51 | 3.58 | 179.92
A10 | -117.98 | 109.92 | | A52 | 3.58 | 199.92
A11 | -117.98 | 119.92 | | A53 | 23.58 | 39.92

A12 | -117.98 | 129.92 | | A54 | 23.58 | 59.92
A13 | -117.98 | 139.92 | | A55 | 23.58 | 99.92
A14 | -117.98 | 149.92 | | A56 | 23.58 | 119.92
A15 | -117.98 | 159.92 | | A57 | 23.58 | 139.92
A16 | -117.98 | 169.92 | | A58 | 23.58 | 159.92
A17 | -56.43 | 39.92 | | A59 | 23.58 | 179.92
A18 | -56.43 | 59.92 | | A60 | 23.58 | 199.92
A19 | -56.43 | 79.92 | | A61 | 43.58 | 39.92

A20 | -56.43 | 99.92 | | A62 | 43.58 | 59.92
A21 | -56.43 | 119.92 | | A63 | 43.58 | 79.92
A22 | -56.43 | 139.92 | | A64 | 43.58 | 99.92
A23 | -56.43 | 159.92 | | A65 | 43.58 | 119.92 | | TAG | XLOC | YLOC | SIZE
A24 | -56.43 | 179.92 | | A66 | 43.58 | 139.92 | | A85 | 125.13 | 139.92 | 5.5±0.25

A26 | -56.43 | 219.92 | A68 | 43.58 | 179.92 | A87 | 125.13 | 159.92
A27 | -36.43 | 39.92 | A69 | 43.58 | 199.92 | A88 | 125.13 | 169.92
A28 | -36.43 | 59.92 | A70 | 43.58 | 219.92 | A89 | 135.13 | 99.92
A29 | -36.43 | 79.92 | A71 | 63.58 | 39.92 | A90 | 135.13 | 109.92
A30 | -36.43 | 99.92 | A72 | 63.58 | 59.92 | A91 | 135.13 | 119.92
A31 | -36.43 | 119.92 | A73 | 63.58 | 79.92 | A92 | 135.13 | 129.92
A32 | -36.43 | 139.92 | A74 | 63.58 | 99.92 | A93 | 135.13 | 139.92
A33 | -36.43 | 159.92 | A75 | 63.58 | 119.92 | A94 | 135.13 | 149.92
A34 | -36.43 | 179.92 | A76 | 63.58 | 139.92 | A95 | 135.13 | 159.92
A35 | -36.43 | 199.92 | A77 | 63.58 | 159.92 | A96 | 135.13 | 169.92
A36 | -36.43 | 219.92 | A78 | 63.58 | 179.92 | A97 | 23.58 | 79.92
A37 | -16.43 | 39.92 | A79 | 63.58 | 199.92 | B1 | -122.07 | 87.29 | 3.4±0.25
A38 | -16.43 | 59.92 | A80 | 63.58 | 219.92 | B2 | -120.49 | 196.82
A39 | -16.43 | 79.92 | A81 | 125.13 | 99.92 | B3 | -48.25 | 24.98
A40 | -16.43 | 99.92 | A82 | 125.13 | 109.92 | B4 | 55.40 | 24.98
A41 | -16.43 | 119.92 | A83 | 125.13 | 119.92 | B5 | 127.64 | 196.82
A42 | -16.43 | 139.92 | A84 | 125.13 | 129.92 | B6 | 129.22 | 87.29

UNLESS OTHERWISE
SPECIFIED
DIMENSIONS ARE IN
MILLIMETERS & GRAMS
INTERPRET DIMENSIONS &
TOLERANCES PER ASME

MOUNTING PLATE, UPPER-TURTLEBOT EUCLID

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

ANY REPRODUCTION IN PART OR AS A WHOLE
